famez/SpoofCIDv2/README.md

Project forked from https://github.com/spoofcid/spoofcid
