famez/SpoofCIDv2/SpoofCIDv2.kicad_pcb

## KiCad design SpoofCIDv2.kicad_pcb (2026-09-01)

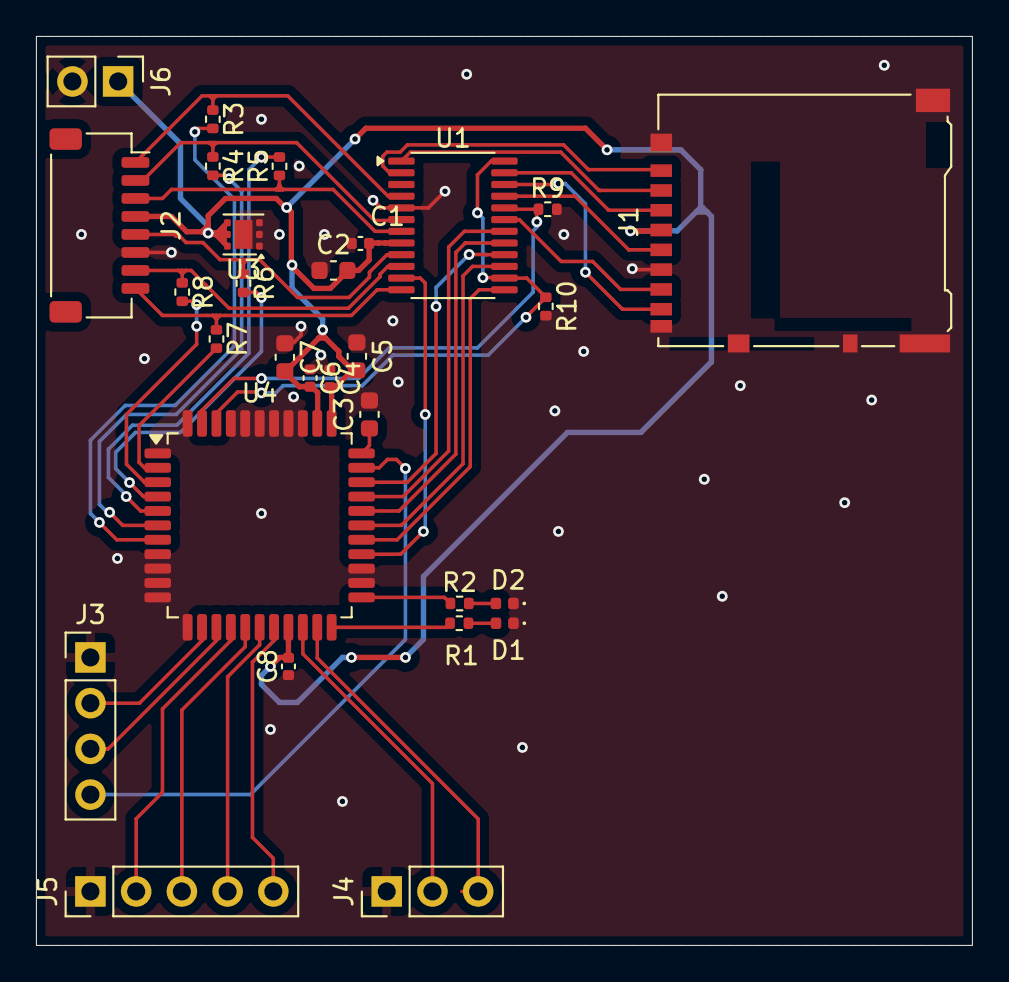
[picture p1: board SpoofCIDv2.kicad_pcb from above]

Board: 2 copper layers, 52.0 x 50.5 mm, 29 parts (0 on the bottom side), 42 nets.

Parts:
C1, C4, C6, C8: 0.1u; C_0402_1005Metric
C2, C5, C7: 2.2u; C_0603_1608Metric
C3: 1.5u; C_0603_1608Metric
D1: GREEN LED; LED_0402_1005Metric
D2: RED LED; LED_0402_1005Metric
J1: Micro_SD_Card; microSD_HC_Hirose_DM3AT-SF-PEJM5
J2: Conn_01x08; JST_SH_SM08B-SRSS-TB_1x08-1MP_P1.00mm_Horizontal
J3: Conn_01x04_Pin; PinHeader_1x04_P2.54mm_Vertical
J4: Conn_01x03_Pin; PinHeader_1x03_P2.54mm_Vertical
J5: Conn_01x05_Pin; PinHeader_1x05_P2.54mm_Vertical
J6: Conn_01x02_Pin; PinHeader_1x02_P2.54mm_Vertical
R1, R3, R4, R5, R6, R7, R8: 100; R_0402_1005Metric
R2: 220; R_0402_1005Metric
R9, R10: 10k; R_0402_1005Metric
U1: TS3A27518EPW; TSSOP-24_4.4x7.8mm_P0.65mm
U3: TVS0500DRV; WSON-6-1EP_2x2mm_P0.65mm_EP1x1.6mm
U4: TQFP-44_10x10mm_P0.8mm

Connections:
+3.3V: C1.2, C2.2, C4.2, C5.2, C6.2, C7.2, C8.2, J1.4 (VDD), J2.4, J6.1, U1.8 (VCC), U3.4 (IN), U3.5 (IN), U3.6 (IN), U4.19 (VDDD), U4.34 (VDDD), U4.35 (VDDA)
/CARD_CLK: J1.5 (CLK), U1.21 (NC4)
/CARD_CMD: J1.3 (CMD), U1.23 (NC3)
/CARD_DAT0: J1.7 (DAT0), U1.19 (NC5)
/CARD_DAT1: J1.8 (DAT1), U1.22 (NC6)
/CARD_DAT2: J1.1 (DAT2), U1.2 (NC1)
/CARD_DAT3: J1.2 (DAT3/CD), U1.1 (NC2)
/HOST_CLK: J2.5, R6.1, U1.9 (COM4)
/HOST_CMD: J2.3, R5.1, U1.7 (COM3)
/HOST_DAT0: J2.7, R8.1, U1.10 (COM5)
/HOST_DAT1: J2.8, R7.1, U1.12 (COM6)
/HOST_DAT2: J2.1, R3.1, U1.4 (COM1)
/HOST_DAT3: J2.2, R4.1, U1.6 (COM2)
/PSOC_CLK: U1.17 (NO4), U4.29 (P0.5)
/PSOC_CMD: U1.15 (NO3), U4.28 (P0.4)
/PSOC_DAT0: U1.18 (NO5), U4.30 (P0.6)
/PSOC_DAT1: U1.16 (NO6), U4.31 (P0.7)
/PSOC_DAT2: U1.11 (NO1), U4.26 (P0.2)
/PSOC_DAT3: U1.13 (NO2), U4.27 (P0.3)
/SWDCLK: J3.3, U4.14 (P3.3)
/SWDIO: J3.2, U4.13 (P3.2)
/UART_RX: J4.2, U4.20 (P4.0)
/UART_TX: J4.3, U4.21 (P4.1)
/XRESET: J3.4, U4.32 (XRES)
GND: C1.1, C2.1, C3.2, C4.1, C5.1, C6.1, C7.1, C8.1, D1.1 (K), D2.1 (K), J1.6 (VSS), J1.9 (SHIELD), J1.10, J1.11, J2.6, J3.1, J4.1, J5.1, J6.2, R9.2, R10.2, U1.5 (GND), U3.1 (GND), U3.2 (GND), U3.3 (GND), U3.7 (GND), U4.1 (VSS), U4.8 (P2.6), U4.9 (P2.7), U4.10 (VSS), U4.11 (P3.0), U4.12 (P3.1), U4.24 (P0.0), U4.25 (P0.1), U4.36 (VSSA), U4.37 (P1.0), U4.38 (P1.1), U4.39 (P1.2), U4.40 (P1.3), U4.41 (P1.4), U4.44 (P1.7)
unnamed: D1.2 (A), R1.2
unnamed: D2.2 (A), R2.2
unnamed: J5.2, U4.15 (P3.4)
unnamed: J5.3, U4.16 (P3.5)
unnamed: J5.4, U4.17 (P3.6)
unnamed: J5.5, U4.18 (P3.7)
unnamed: R10.1, U1.14 (IN2), U1.24 (IN1), U4.42 (P1.5)
unnamed: R9.1, U1.20 (~EN), U4.43 (P1.6)
unnamed: R7.2, U4.2 (P2.0)
unnamed: R8.2, U4.3 (P2.1)
unnamed: R6.2, U4.4 (P2.2)
unnamed: R5.2, U4.5 (P2.3)
unnamed: R4.2, U4.6 (P2.4)
unnamed: R3.2, U4.7 (P2.5)
unnamed: R1.1, U4.22 (P4.2)
unnamed: R2.1, U4.23 (P4.3)
unnamed: C3.1, U4.33 (VCCD)
