famez/SpoofCIDv2/(commit log)

2026-08-31 Modified PCB final version
    [SpoofCIDv2.kicad_pcb, SpoofCIDv2.kicad_sch]
2026-09-01 Changed footprint for C3 to Capacitor_SMD:C_0603_1608Metric
    [SpoofCIDv2.kicad_pcb, SpoofCIDv2.kicad_sch]
2026-09-20 feat: Removed unused wire
    [SpoofCIDv2.kicad_sch]
2026-09-20 feat: Added gerbers, SBOM, placements.
    [bom.csv, designators.csv, positions.csv]
2026-09-20 Add bare-metal firmware for PSoC 4 (led_test + SpoofCID)
    led_test: frozen hardware diagnostic — LED sequence on P4.2/P4.3,
    no UART/UDB/IRQ. Used to verify PCB and programmer before any
    firmware development.
    SpoofCID: phase-1 monitor firmware. Loads SD_CID_RESPONDER UDB
    bitstream (synthesized for HOST_CLK=P2[2], SD_CMD=P2[3]), detects
    CMD2/CMD9 in hardware via UDB StatusReg, reports over UART at
    115200 baud (SCB0, P4.0/P4.1). Read-only — no SD bus writes.
    UDB detection pending debug.
    Claude-Session: https://claude.ai/code/session_01GYRaPDYTaK3iM7KAVzvv42
2026-10-01 Migrate SpoofCID firmware to PSoC Creator; add SD_CID_RESPONDER UDB component
    - Remove firmware/SpoofCID/ bare-metal build (Makefile, startup.s, psoc_stubs, main.c)
    - Add psoc_creator/ project: TopDesign with UART_1 + SD_CID_RESPONDER_1 components
    - SD_CID_RESPONDER: read-only UDB sniffer — detects CMD2/CMD9 on SD bus via
    cy_psoc3_status registers; never drives the bus (CMD_OVERRIDE tied to 0)
    - main.c uses PSoC Creator HAL (UART_1_Start, CY_GET_REG8) — no manual inits
    - Verified on hardware: CMD2 ALL_SEND_CID and CMD9 SEND_CSD detected correctly
    - Update .gitignore: exclude PSoC Creator build output (CortexM0/) and firmware binaries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
    [SD_CID_RESPONDER.v]
2026-10-03 feat: PSoC Creator firmware — SD bus CID/CSD sniffer via UDB
    Migrates the SpoofCIDv2 firmware to PSoC Creator and implements a passive
    SD bus sniffer that captures the CID and CSD registers in hardware.
    Hardware (SD_CID_RESPONDER UDB component):
    - FSM decodes SD framing (start/dir bits, command vs. response phase) and
    detects CMD2 (ALL_SEND_CID) and CMD9 (SEND_CSD) on the SD_CMD line.
    - 8-bit unconditional shift register samples SD_CMD every HOST_CLK cycle;
    CaptureReg (cy_psoc3_status, clk_n) latches a complete byte at each
    negedge. dbg1_r delays the byte-ready pulse by 1 cycle so the CPU ISR
    reads CaptureReg only after the latch has settled.
    - DBG0 (level) triggers SD_CMD_ISR on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
2026-10-04 fix: align CID/CSD output to standard Linux format
    Apply 6-bit left shift reconstruction in uart_buf so UART output matches
    /sys/bus/mmc/devices/*/cid and */csd byte-for-byte. The R2 frame FSM
    consumes start+dir bits via state transitions, leaving a 6-bit reserved
    header prefix (0b111111) at the MSB of each first captured byte. Formula:
    LinuxByte[i] = (capture[i] << 6) | (capture[i+1] >> 2)
    Last byte has 6 LSBs zeroed (CRC7 + end bit fall outside the 134 counted
    bits); bytes 0-14 are exact.
    [main.c]
2026-10-08 feat: UDB spoofer on HFCLK with self-terminating frames
    - UDB runs on HFCLK (24 MHz); HOST_CLK is a synced data input whose rising
    edge enables the logic (UDB Clock/Enable). No pin-routed clocks: no hold
    violations or async crossings.
    - HOST_CMD delayed 2 extra stages so it is sampled 42-84 ns before the
    host's rising edge. Pins HOST_CLK and CARD_CMD set to Double-Sync.
    - TX shift register in a UDB datapath (A0, CPU writes D0).
    - 8-bit frame counter: FSM leaves RESPONSE by itself after 48 bits, or
    136 bits for the R2 of CMD2/CMD9, releasing SW_IN in hardware. A new
    command clears a stale detection.
    - Firmware: frames precomputed at boot, silent minimal startup, late
    CMD_DET guard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
2026-10-10 fix: correct CRC7 for R2 frames; spoof only the CID
    - crc7_compute compared the data bit with the CRC MSB before shifting,
    producing a wrong CRC (CMD0 gave 0x37 instead of 0x4A). Linux rejected
    the spoofed R2 and retried CMD2, which the card (already in ident
    state) ignored, so the host power-cycled the bus. Now matches the SD
    spec vectors (CMD0 0x95, CMD8 0x87).
    - SPOOF_CSD_ENABLE (0): on CMD9 the bus is not taken and the real CSD
    passes through; a made-up CSD would break capacity/timing.
    - Real CID of the test card kept as a comment.
    Verified on hardware (single board, CARD_CLK bodge, Linux camera):
    /sys/.../cid = 1b534d534433324780deadbeef012300.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
    [main.c]
